Draggfive/Air_Quality_IoT/Eagle PCB/CAMOutputs_Probe/Assembly/Probe_BOM.xlsx

Item # | Designator | Qty | Manufacturer | Mfg Part # | Description | Value | Package | Type
1 | R1 | 1 | Panasonic | ERJ-2RHD1601X | RESISTOR, European symbol | 1.6k ohm | R0402 | R-EU_R0402
2 | R2 | 1 | Panasonic | ERJ-2RHD3300X | RESISTOR, European symbol | 330 ohm | R0402 | R-EU_R0402
3 | R3, R4 | 2 | Panasonic | ERA-2AED103X | RESISTOR, European symbol | 10k ohm | R0402 | R-EU_R0402
4 | R5 | 1 | Panasonic | ERJ-U02D2700X | RESISTOR, European symbol | 270 ohm | R0402 | R-EU_R0402
5 | R6 | 1 | Panasonic | ERA-2AED361X | RESISTOR, European symbol | 360 ohm | R0402 | R-EU_R0402
6 | R7, R8 | 2 | Panasonic | ERJ-2RHD471X | RESISTOR, European symbol | 470 ohm | R0402 | R-EU_R0402
7 | R9, R10, R11, R12 | 4 | Panasonic | ERJ-U02D1001X | RESISTOR, European symbol | 1k ohm | R0402 | R-EU_R0402
8 | C1, C16 | 2 | TDK | C1608X5R0J106K080AE | CAPACITOR, European symbol | 10uF | C0603 | C-EUC0603
9 | C2, C5, C6, C9, C10, C11, C13, C14, C15, C17, C18, C19 | 12 | TDK | CGA2B1X7R1C104K050BC | CAPACITOR, European symbol | 0.1uF | C0402 | C-EUC0402
10 | C3, C4 | 2 | TDK | C2012X7R1H475K125AC | CAPACITOR, European symbol | 4.7uF | C0805 | C-EUC0805
11 | C7, C8 | 2 | TDK | CGA1A2C0G1E120J030BA | CAPACITOR, European symbol | 12.5pF | C0201 | C-EUC0201
12 | C12 | 1 | TDK | C1005X7R1A224K050BB | CAPACITOR, European symbol | 220nF | C0402 | C-EUC0402
13 | D1 | 1 | Wurth Elektronik | 150060GS55040 | WL-SMCD SMT Mono-color Chip LED Diffused | Green | WL-SMCD_0603 | WL-SMCD_0603_150060GS55040
14 | D2 | 1 | Wurth Elektronik | 150060RS55040 | WL-SMCD SMT Mono-color Chip LED Diffused | Red | WL-SMCD_0603 | WL-SMCD_0603_150060RS55040
15 | D3 | 1 | Wurth Elektronik | 150060BS55040 | WL-SMCD SMT Mono-color Chip LED Diffused | Blue | WL-SMCD_0603 | WL-SMCD_0603_150060BS55040
16 | D4 | 1 | Wurth Elektronik | 150060YS55040 | WL-SMCD SMT Mono-color Chip LED Diffused | Yellow | WL-SMCD_0603 | WL-SMCD_0603_150060YS55040
17 | IC1 | 1 | Diodes Incorporated | ZLDO1117G33TA | 1A Low Dropout (LDO) Positive Regulator | REG1117 | SOT223 | REG1117
18 | U1 | 1 | Microchip | PIC32MX170F256D-I/PT | 32-bit PIC Microcontroller | PIC32MX170F256D- | TQFP44_10X10MC | PIC32MX170F256
19 | U2 | 1 | Texas Instruments | TPS2085D | CI commutateur d'alimentation - Alimentation 0.7A 2.7-5.5V Quad Hi-Side MOSFET | TPS2085_D_16 | D16 | TPS2085_D_16
20 | U3 | 1 | Ai-Thinker | Ra-02 | Ra-02 LoRa RF M5Stack Platform Evaluation Expansion Board | RA-02_LORA | MODULE_RA-02_LORA | RA-02_LORA
21 | U4 | 1 | Adafruit | 790 | GPS Module - MTK MT3339 Chipset, -165dBm sensitivity, 22 channels, 10Hz, auto-select external antenna options |  | FGPMMOPA6H | GPS_FGPMMOPA6H
22 | U5 | 1 | Bosch Sensortec | BMP388 | P-Sensor SPI I2C 1, 25 Bar SMD | BMP388 | PQFN50P200X200X80-10N | BMP388
23 | U6 | 1 | STMicroelectronics | IIS2MDCTR | Effet Hall/Capteurs magnétiques enfichables CONSUMER MEMS | IIS2MDCTR | LGA12R50P4X4_200X200X70 | IIS2MDCTR
24 | U7 | 1 | TDK InvenSense | ICM-20649 | Wide-Range 6-Axis MEMS MotionTracking Device for Sports and High Impact Applications Check prices | ICM-20649 | QFN40P300X300X95-24N | ICM-20649
25 | U8 | 1 | Wurth Elektronik | 2525020210001 | WSEN-HIDS - 2525020210001 | WSEN-HIDS_2525020210001 | WSEN-HIDS_2525020210001_SIMPLE | WSEN-HIDS_2525020210001_SIMPLE
26 | X1 | 1 | Hirose Connector | U.FL-R-SMT(10) | U.FL Antenna Connector |  | U.FL | ANTENNA_U.FL
27 | Y1 | 1 | Wurth Elektronik | 830009678 | WE-XTAL Watch Crystals | 32.768kHz | WE-XTAL_CFPX-217 | WE-XTAL_CFPX-217_830009678
