Draggfive/Air_Quality_IoT/SOLIDWORKS Cases/Case_Air/Case_Air.SLDPRT

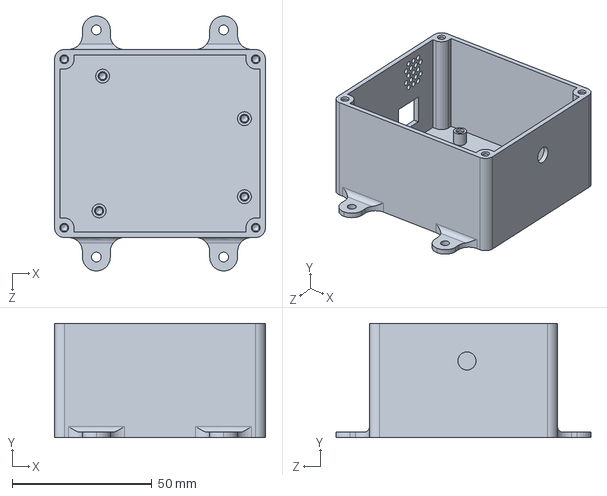
[picture p1: CAD file, 2021-03-29]
SOLIDWORKS Cases/Case_Air/Case_Air.SLDPRT
75.6 x 41.0 x 91.3 mm
