Draggfive/Air_Quality_IoT/SOLIDWORKS Cases/Case_Gateway/Cover_Gateway.SLDPRT

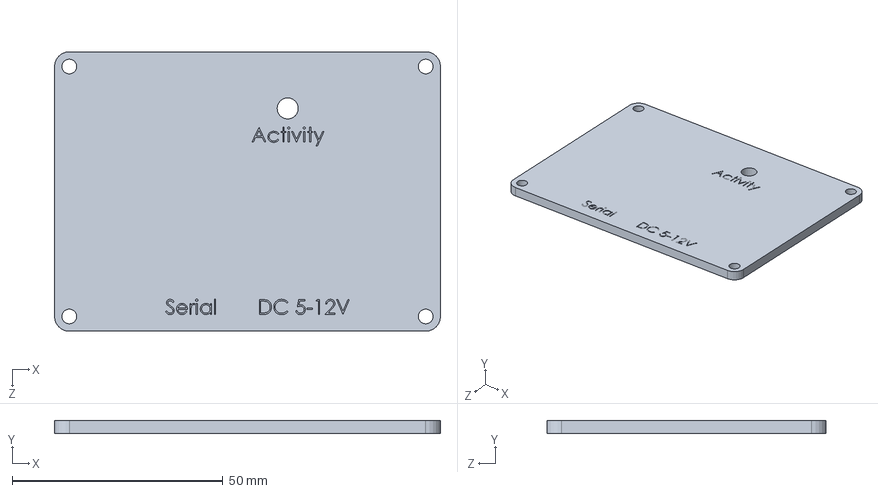
[picture p2: CAD file, 2021-03-29]
SOLIDWORKS Cases/Case_Gateway/Cover_Gateway.SLDPRT
91.5 x 3.00 x 66.2 mm
