Draggfive/Air_Quality_IoT/SOLIDWORKS Cases/Case_Air/Cover_Air.SLDPRT

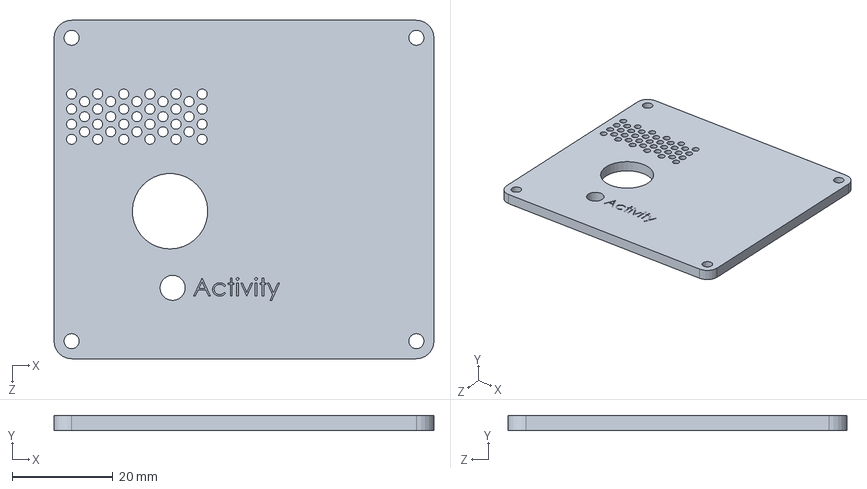
[picture p3: CAD file, 2021-03-29]
SOLIDWORKS Cases/Case_Air/Cover_Air.SLDPRT
75.6 x 3.00 x 67.3 mm
