Draggfive/Air_Quality_IoT/SOLIDWORKS Cases/Case_Gateway/Case_Gateway.SLDPRT

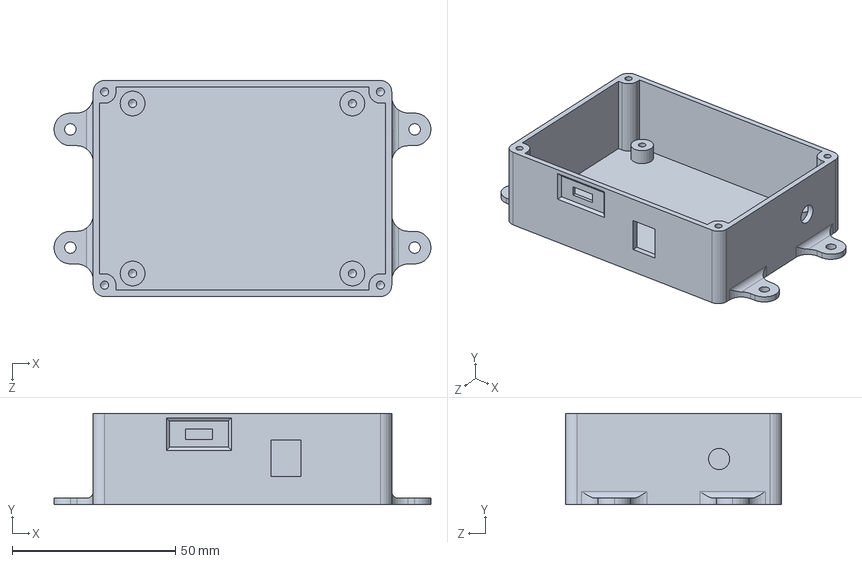
[picture p4: CAD file, 2021-03-29]
SOLIDWORKS Cases/Case_Gateway/Case_Gateway.SLDPRT
115.5 x 28.0 x 66.2 mm
