Draggfive/Air_Quality_IoT/(list of files, cad)

Other CAD files:
SOLIDWORKS Cases/Case_Air/Case_Air.3MF
SOLIDWORKS Cases/Case_Air/Cover_Air.DXF
SOLIDWORKS Cases/Case_Gateway/Case_Gateway.3MF
SOLIDWORKS Cases/Case_Gateway/Cover_Gateway.DXF
