Draggfive/Air_Quality_IoT/Eagle PCB/Probe.brd

## EAGLE design Eagle PCB/Probe.brd (2021-03-29)

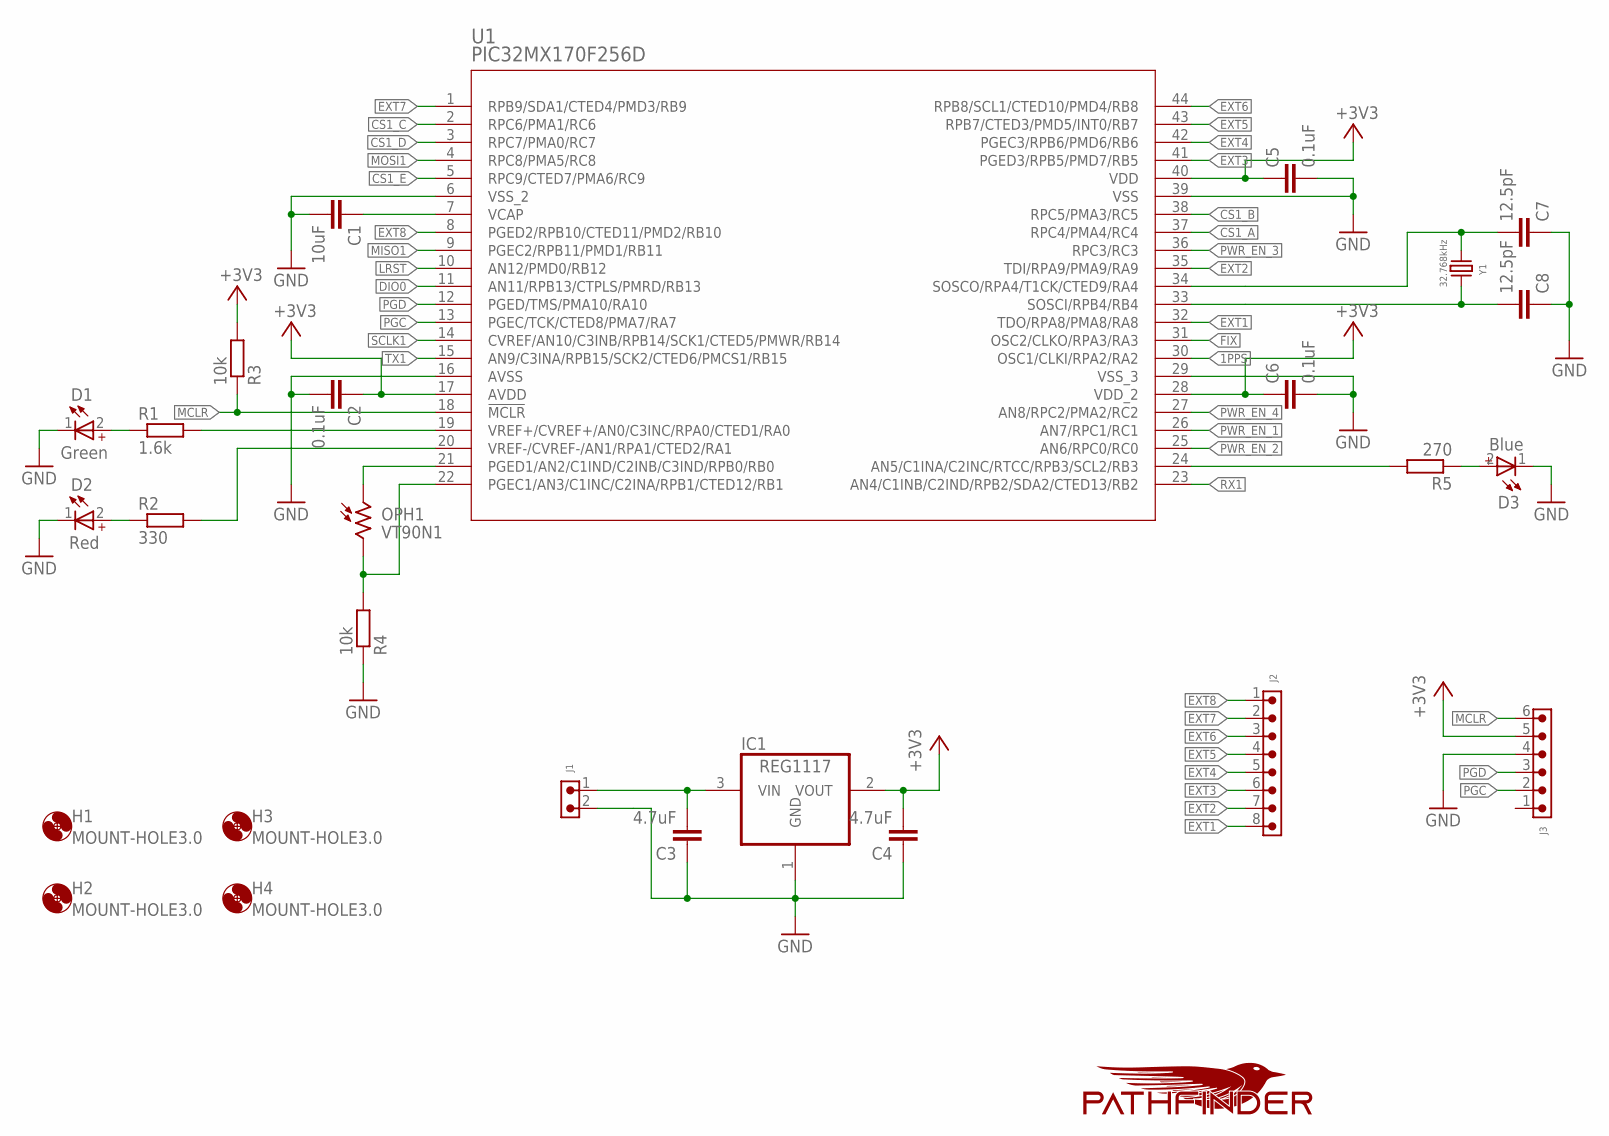
[picture p5: schematic Probe.sch, sheet 1]

Parts:
C1: 10uF; C0603
C2, C5, C6: 0.1uF; C0402
C3, C4: 4.7uF; C0805
C7, C8: 12.5pF; C0201
D1: Green; WL-SMCD_0603
D2: Red; WL-SMCD_0603
D3: Blue; WL-SMCD_0603
H1, H2, H3, H4: MOUNT-HOLE3.0; 3,0
IC1: REG1117; SOT223
J1: 6130XX11021_61300211021; 61300211021
J2: 6130XX11021_61300811021; 61300811021
J3: 6130XX11021_61300611021; 61300611021
OPH1: VT90N1; VT900
R1: 1.6k; R0402
R2: 330; R0402
R3, R4: 10k; R0402
R5: 270; R0402
U1: PIC32MX170F256D; TQFP44_10X10MC
U$1: PATHFINDER_LOGO24MM_6MIL_S; PATHFINDER_LOGO_24MM_6MIL_SERIGRAPHY
Y1: 32.768kHz; WE-XTAL_CFPX-217

Connections:
1PPS: U1.30 (OSC1/CLKI/RPA2/RA2); also elsewhere on the board
+3V3: C2.1, C4.2, C5.1, C6.1, IC1.2 (VOUT), J3.5, R3.2, U1.17 (AVDD), U1.28 (VDD_2), U1.40 (VDD); also elsewhere on the board
CS1_A: U1.37 (RPC4/PMA4/RC4); also elsewhere on the board
CS1_B: U1.38 (RPC5/PMA3/RC5); also elsewhere on the board
CS1_C: U1.2 (RPC6/PMA1/RC6); also elsewhere on the board
CS1_D: U1.3 (RPC7/PMA0/RC7); also elsewhere on the board
CS1_E: U1.5 (RPC9/CTED7/PMA6/RC9); also elsewhere on the board
DIO0: U1.11 (AN11/RPB13/CTPLS/PMRD/RB13); also elsewhere on the board
EXT1: J2.8, U1.32 (TDO/RPA8/PMA8/RA8)
EXT2: J2.7, U1.35 (TDI/RPA9/PMA9/RA9)
EXT3: J2.6, U1.41 (PGED3/RPB5/PMD7/RB5)
EXT4: J2.5, U1.42 (PGEC3/RPB6/PMD6/RB6)
EXT5: J2.4, U1.43 (RPB7/CTED3/PMD5/INT0/RB7)
EXT6: J2.3, U1.44 (RPB8/SCL1/CTED10/PMD4/RB8)
EXT7: J2.2, U1.1 (RPB9/SDA1/CTED4/PMD3/RB9)
EXT8: J2.1, U1.8 (PGED2/RPB10/CTED11/PMD2/RB10)
FIX: U1.31 (OSC2/CLKO/RPA3/RA3); also elsewhere on the board
GND: C1.2, C2.2, C3.1, C4.1, C5.2, C6.2, C7.1, C8.1, D1.1 (_), D2.1 (_), D3.1 (_), IC1.1 (GND), J1.2, J3.4, R4.1, U1.6 (VSS_2), U1.16 (AVSS), U1.29 (VSS_3), U1.39 (VSS); also elsewhere on the board
LRST: U1.10 (AN12/PMD0/RB12); also elsewhere on the board
MCLR: J3.6, R3.1, U1.18 (!MCLR)
MISO1: U1.9 (PGEC2/RPB11/PMD1/RB11); also elsewhere on the board
MOSI1: U1.4 (RPC8/PMA5/RC8); also elsewhere on the board
unnamed: C1.1, U1.7 (VCAP)
unnamed: C7.2, U1.34 (SOSCO/RPA4/T1CK/CTED9/RA4), Y1.2
unnamed: C8.2, U1.33 (SOSCI/RPB4/RB4), Y1.1
unnamed: D1.2 (+), R1.1
unnamed: D2.2 (+), R2.1
unnamed: OPH1.1, U1.21 (PGED1/AN2/C1IND/C2INB/C3IND/RPB0/RB0)
unnamed: R1.2, U1.19 (VREF+/CVREF+/AN0/C3INC/RPA0/CTED1/RA0)
unnamed: R2.2, U1.20 (VREF-/CVREF-/AN1/RPA1/CTED2/RA1)
unnamed: OPH1.2, R4.2, U1.22 (PGEC1/AN3/C1INC/C2INA/RPB1/CTED12/RB1)
unnamed: C3.2, IC1.3 (VIN), J1.1
unnamed: R5.2, U1.24 (AN5/C1INA/C2INC/RTCC/RPB3/SCL2/RB3)
unnamed: D3.2 (+), R5.1
PGC: J3.2, U1.13 (PGEC/TCK/CTED8/PMA7/RA7)
PGD: J3.3, U1.12 (PGED/TMS/PMA10/RA10)
PWR_EN_1: U1.26 (AN7/RPC1/RC1); also elsewhere on the board
PWR_EN_2: U1.25 (AN6/RPC0/RC0); also elsewhere on the board
PWR_EN_3: U1.36 (RPC3/RC3); also elsewhere on the board
PWR_EN_4: U1.27 (AN8/RPC2/PMA2/RC2); also elsewhere on the board
RX1: U1.23 (AN4/C1INB/C2IND/RPB2/SDA2/CTED13/RB2); also elsewhere on the board
SCLK1: U1.14 (CVREF/AN10/C3INB/RPB14/SCK1/CTED5/PMWR/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); also elsewhere on the board
TX1: U1.15 (AN9/C3INA/RPB15/SCK2/CTED6/PMCS1/RB15); also elsewhere on the board

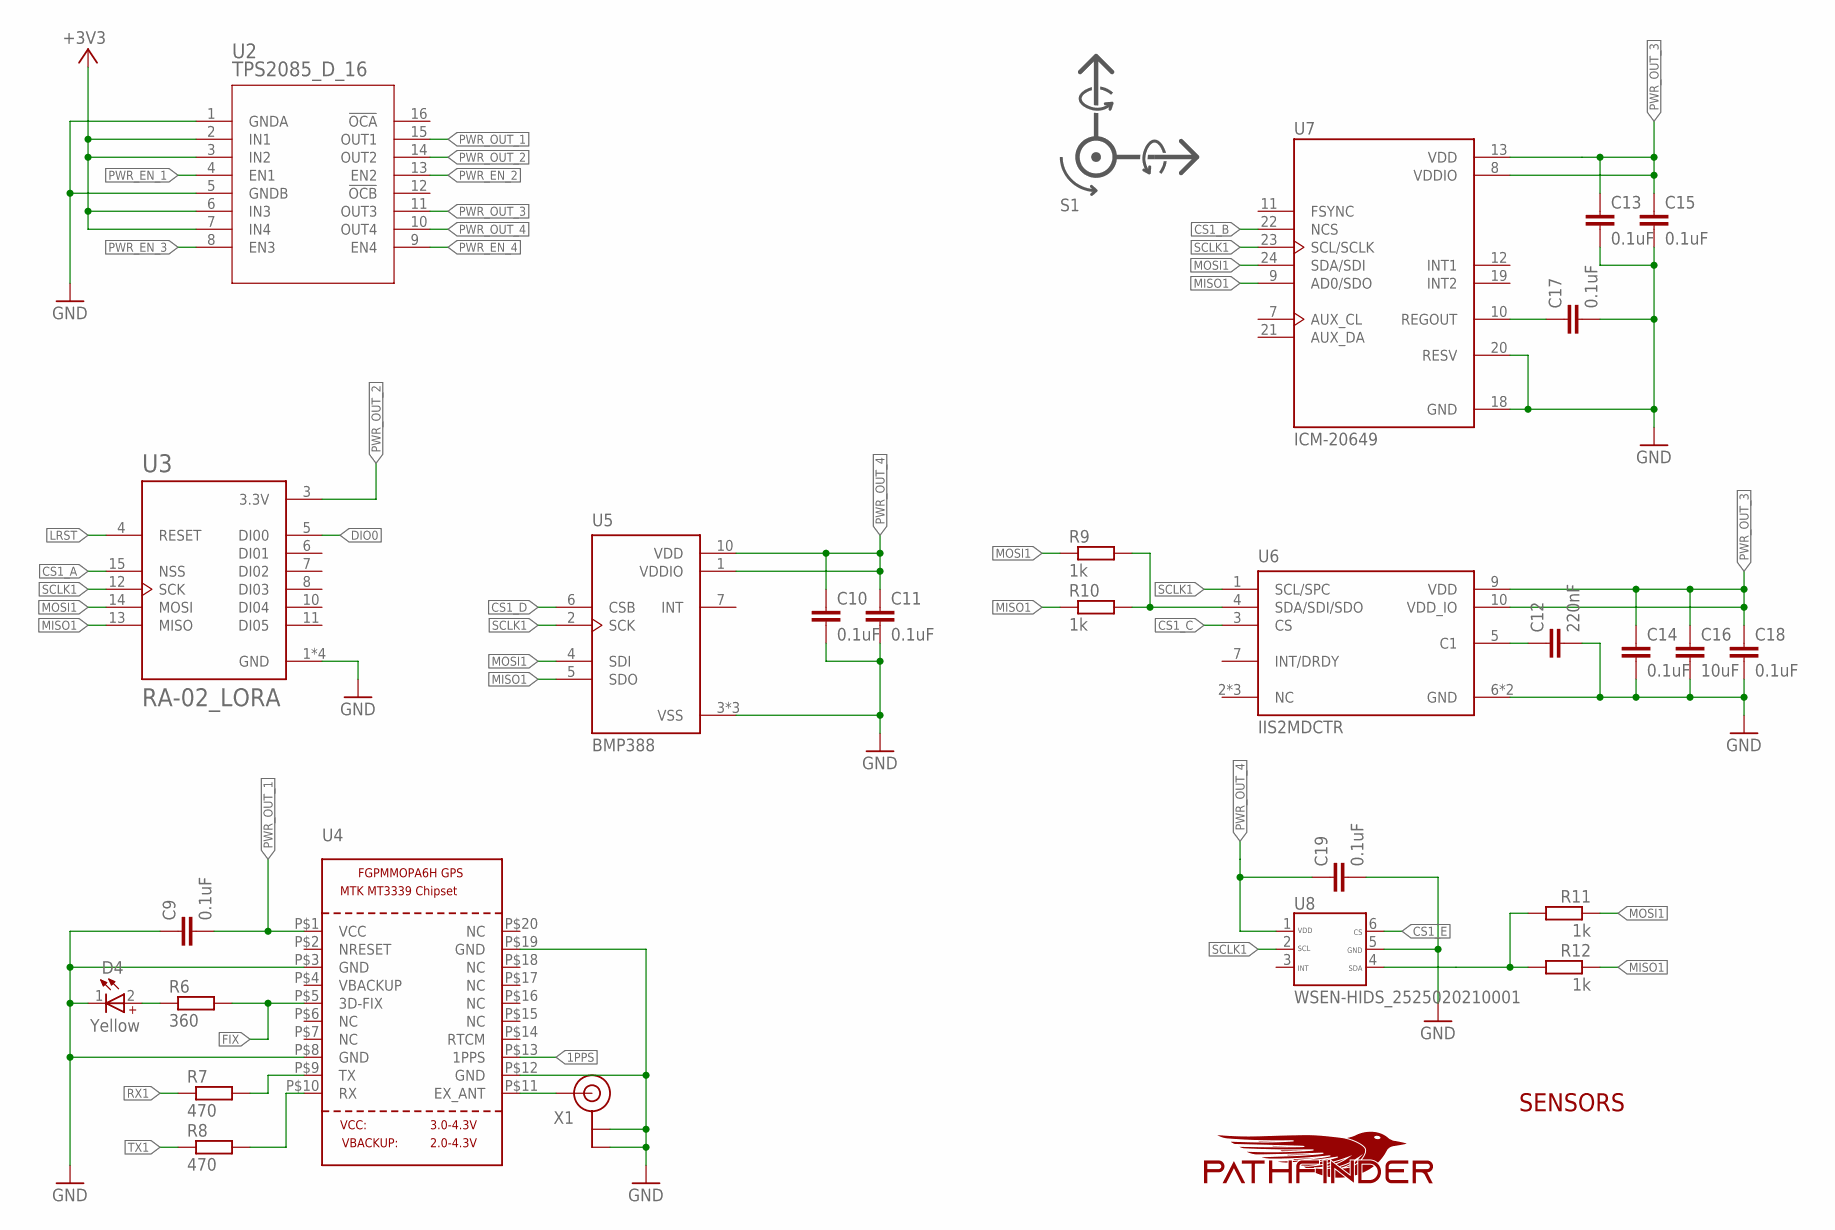
[picture p6: schematic Probe.sch, sheet 2]

Parts:
C9, C10, C11, C13, C14, C15, C17, C18, C19: 0.1uF; C0402
C12: 220nF; C0402
C16: 10uF; C0603
D4: Yellow; WL-SMCD_0603
R6: 360; R0402
R7, R8: 470; R0402
R9, R10, R11, R12: 1k; R0402
S1: COORDINATE_SYSTEM; DIRECT_AXES
U2: TPS2085_D_16; D16
U3: RA-02_LORA; MODULE_RA-02_LORA
U4: GPS_FGPMMOPA6H; FGPMMOPA6H
U5: BMP388; PQFN50P200X200X80-10N
U6: IIS2MDCTR; LGA12R50P4X4_200X200X70
U7: ICM-20649; QFN40P300X300X95-24N
U8: WSEN-HIDS_2525020210001; WSEN-HIDS_2525020210001_SIMPLE
U$2: PATHFINDER_LOGO24MM_6MIL_S; PATHFINDER_LOGO_24MM_6MIL_SERIGRAPHY
X1: ANTENNA_U.FL; U.FL

Connections:
1PPS: U4.P$13 (1PPS); also elsewhere on the board
+3V3: U2.2 (IN1), U2.3 (IN2), U2.6 (IN3), U2.7 (IN4); also elsewhere on the board
CS1_A: U3.15 (NSS); also elsewhere on the board
CS1_B: U7.22 (NCS); also elsewhere on the board
CS1_C: U6.3 (CS); also elsewhere on the board
CS1_D: U5.6 (CSB); also elsewhere on the board
CS1_E: U8.6 (CS); also elsewhere on the board
DIO0: U3.5 (DI00); also elsewhere on the board
FIX: R6.2, U4.P$5 (3D-FIX); also elsewhere on the board
GND: C9.1, C10.2, C11.2, C12.2, C13.2, C14.2, C15.2, C16.2, C17.2, C18.2, C19.2, D4.1 (_), U2.1 (GNDA), U2.5 (GNDB), U3.1 (GND), U3.2 (GND), U3.9 (GND), U3.16 (GND), U4.P$3 (GND), U4.P$8 (GND), U4.P$12 (GND), U4.P$19 (GND), U5.3 (VSS), U5.8 (VSS), U5.9 (VSS), U6.6 (GND), U6.8 (GND), U7.18 (GND), U7.20 (RESV), U8.5 (GND), X1.1 (GND), X1.2 (GND); also elsewhere on the board
LRST: U3.4 (RESET); also elsewhere on the board
MISO1: R10.1, R12.1, U3.13 (MISO), U5.5 (SDO), U7.9 (AD0/SDO); also elsewhere on the board
MOSI1: R9.1, R11.1, U3.14 (MOSI), U5.4 (SDI), U7.24 (SDA/SDI); also elsewhere on the board
unnamed: C17.1, U7.10 (REGOUT)
unnamed: D4.2 (+), R6.1
unnamed: U4.P$11 (EX_ANT), X1.3 (SIGNAL)
unnamed: R7.2, U4.P$9 (TX)
unnamed: R8.2, U4.P$10 (RX)
unnamed: R9.2, R10.2, U6.4 (SDA/SDI/SDO)
unnamed: C12.1, U6.5 (C1)
unnamed: R11.2, R12.2, U8.4 (SDA)
PWR_EN_1: U2.4 (EN1); also elsewhere on the board
PWR_EN_2: U2.13 (EN2); also elsewhere on the board
PWR_EN_3: U2.8 (EN3); also elsewhere on the board
PWR_EN_4: U2.9 (EN4); also elsewhere on the board
PWR_OUT_1: C9.2, U2.15 (OUT1), U4.P$1 (VCC)
PWR_OUT_2: U2.14 (OUT2), U3.3 (3.3V)
PWR_OUT_3: C13.1, C14.1, C15.1, C16.1, C18.1, U2.11 (OUT3), U6.9 (VDD), U6.10 (VDD_IO), U7.8 (VDDIO), U7.13 (VDD)
PWR_OUT_4: C10.1, C11.1, C19.1, U2.10 (OUT4), U5.1 (VDDIO), U5.10 (VDD), U8.1 (VDD)
RX1: R7.1; also elsewhere on the board
SCLK1: U3.12 (SCK), U5.2 (SCK), U6.1 (SCL/SPC), U7.23 (SCL/SCLK), U8.2 (SCL); also elsewhere on the board
TX1: R8.1; also elsewhere on the board

Notes on the sheet:
SENSORS

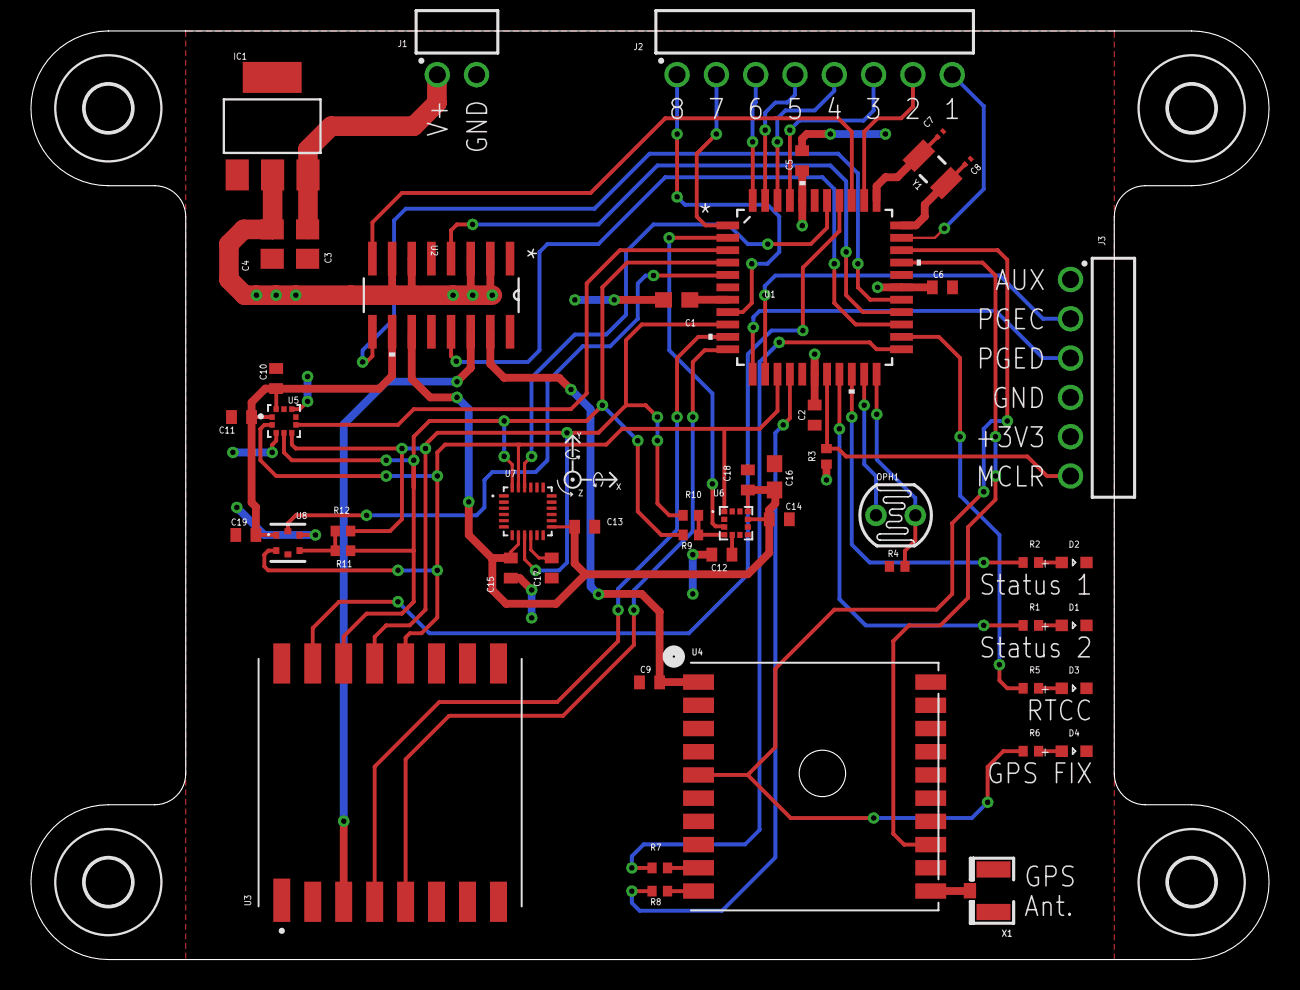
[picture p7: board Probe.brd from above]

Board: 2 copper layers, 80.0 x 60.0 mm, 57 parts (1 on the bottom side), 55 nets.
