Draggfive/Air_Quality_IoT/Eagle PCB/Gateway.brd

## EAGLE design Eagle PCB/Gateway.brd (2021-03-29)

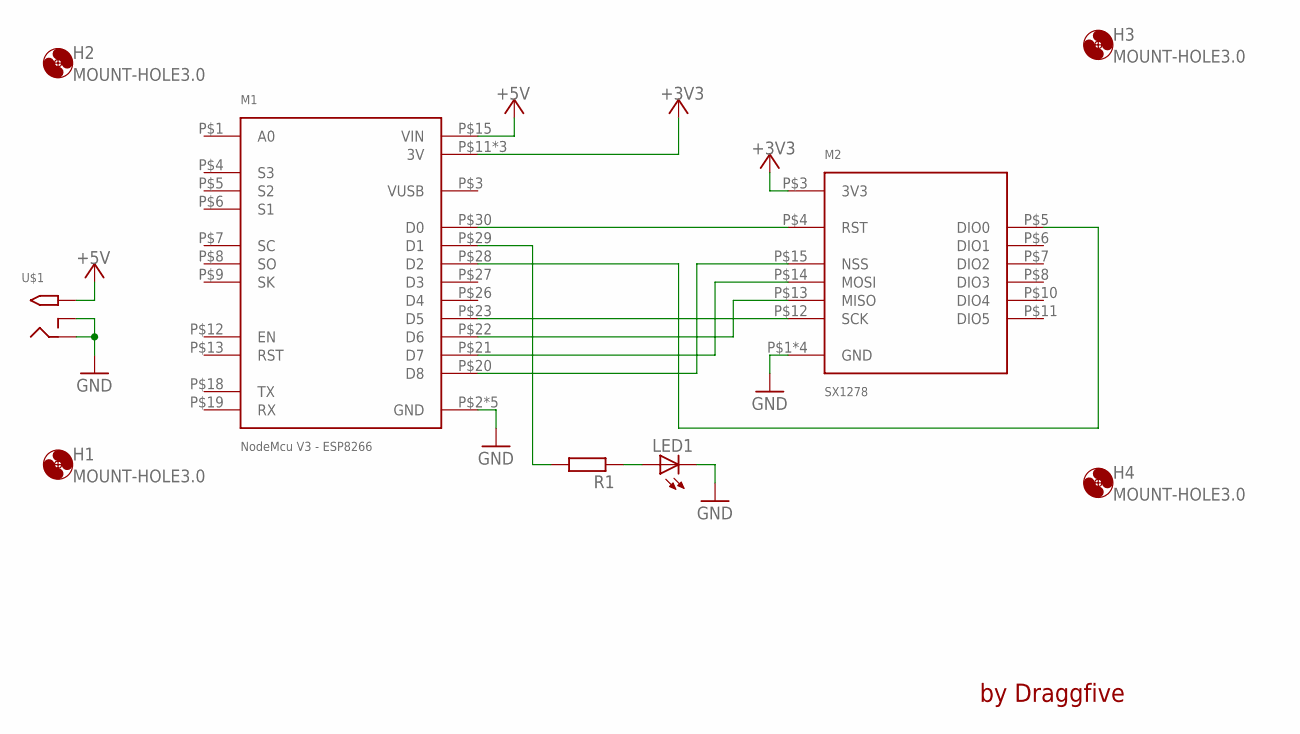
[picture p8: schematic Gateway.sch]

Parts:
H1, H2, H3, H4: MOUNT-HOLE3.0; 3,0
LED1: LED5MM
M1: NodeMcu V3 - ESP8266; NODEMCU_V3
M2: SX1278
R1: R-EU_0207/10; 0207/10
U$1: 2.1MMJACKTHM; PJ-102A

Connections:
+3V3: M1.P$11 (3V), M1.P$16 (3V), M1.P$25 (3V), M2.P$3 (3V3)
+5V: M1.P$15 (VIN), U$1.TIP
GND: LED1.K (C), M1.P$2 (GND), M1.P$10 (GND), M1.P$14 (GND), M1.P$17 (GND), M1.P$24 (GND), M2.P$1 (GND), M2.P$2 (GND), M2.P$9 (GND), M2.P$16 (GND), U$1.RING, U$1.RING_SW
unnamed: M1.P$29 (D1), R1.2
unnamed: M1.P$30 (D0), M2.P$4 (RST)
unnamed: M1.P$28 (D2), M2.P$5 (DIO0)
unnamed: M1.P$23 (D5), M2.P$12 (SCK)
unnamed: M1.P$22 (D6), M2.P$13 (MISO)
unnamed: M1.P$21 (D7), M2.P$14 (MOSI)
unnamed: M1.P$20 (D8), M2.P$15 (NSS)
unnamed: LED1.A, R1.1

Notes on the sheet:
by Draggfive

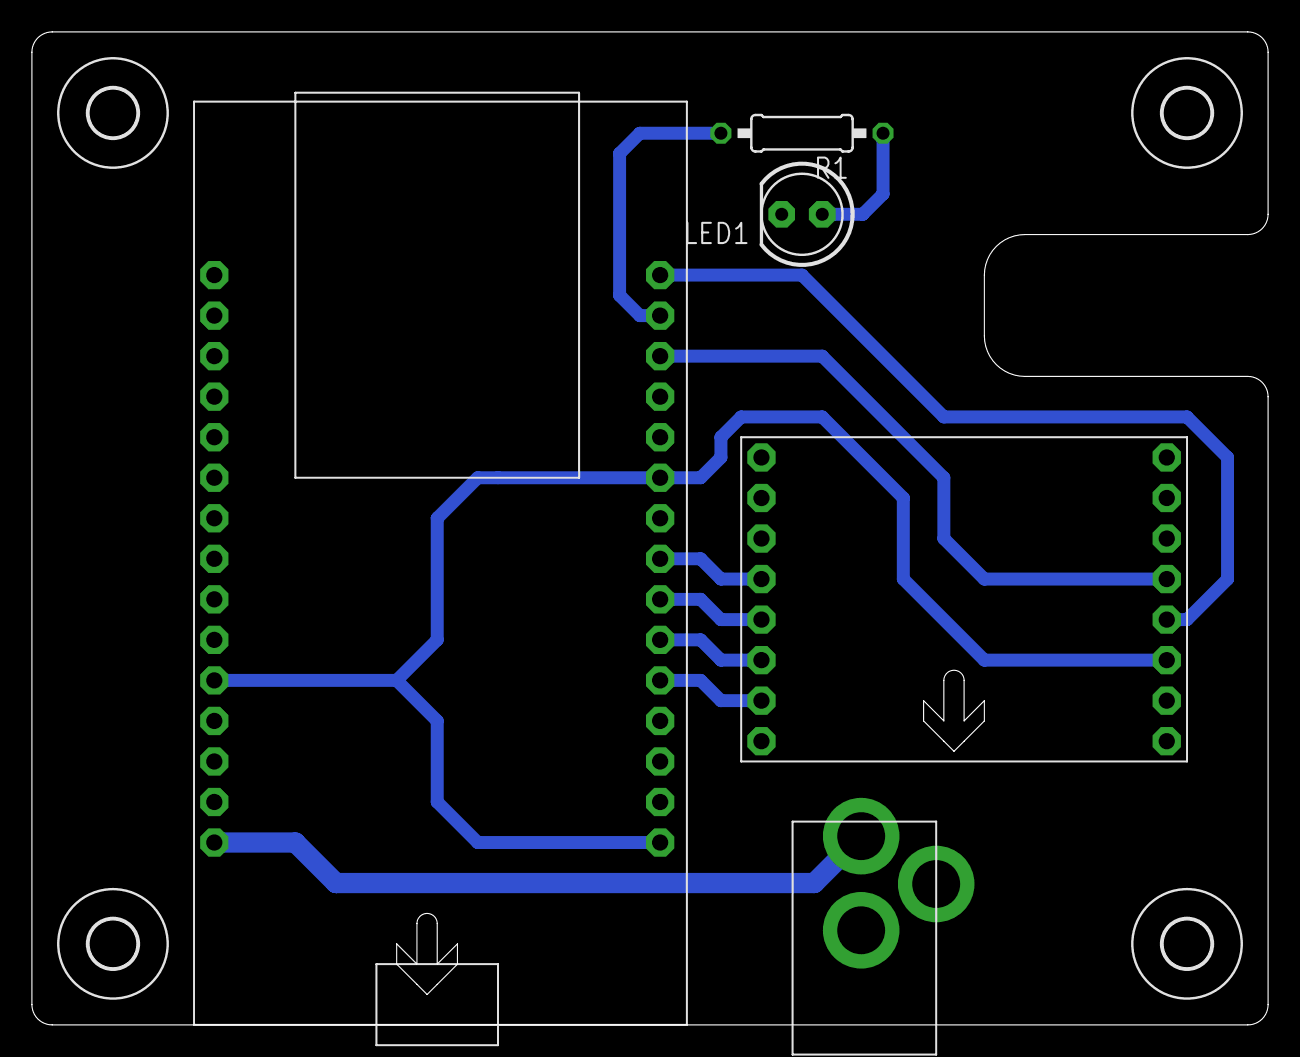
[picture p9: board Gateway.brd from above]

Board: 2 copper layers, 77.5 x 62.2 mm, 9 parts (0 on the bottom side), 11 nets.
