Draggfive/Air_Quality_IoT/Eagle PCB/Air Quality.brd

## EAGLE design Eagle PCB/Air Quality.brd (2021-03-29)

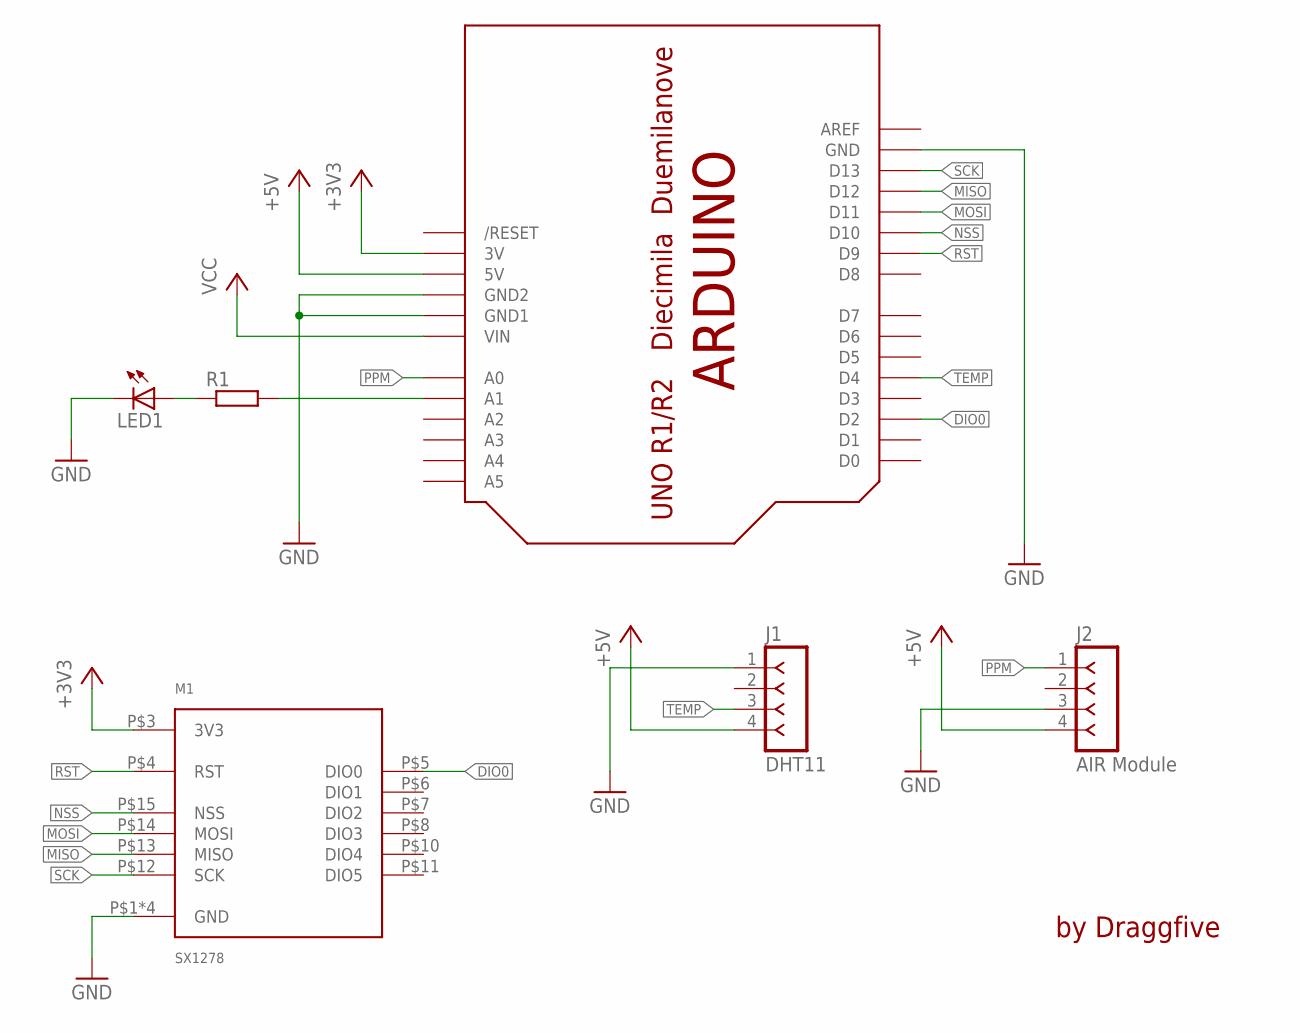
[picture p10: schematic Air Quality.sch]

Parts:
J1: DHT11; SIP-100-04-32Y
J2: AIR Module; SIP-100-04-40Y
LED1: LED5MM
M1: SX1278
R1: R-EU_0207/10; 0207/10
U$1: ARDUINOUNO; ARDUINO

Connections:
+3V3: M1.P$3 (3V3), U$1.3V
+5V: J1.4, J2.4, U$1.5V
DIO0: M1.P$5 (DIO0), U$1.D2
GND: J1.1, J2.3, LED1.K (C), M1.P$1 (GND), M1.P$2 (GND), M1.P$9 (GND), M1.P$16 (GND), U$1.GND, U$1.GND1, U$1.GND2
MISO: M1.P$13 (MISO), U$1.D12
MOSI: M1.P$14 (MOSI), U$1.D11
unnamed: LED1.A, R1.1
unnamed: R1.2, U$1.A1
NSS: M1.P$15 (NSS), U$1.D10
PPM: J2.1, U$1.A0
RST: M1.P$4 (RST), U$1.D9
SCK: M1.P$12 (SCK), U$1.D13
TEMP: J1.3, U$1.D4
VCC: U$1.VIN

Notes on the sheet:
by Draggfive

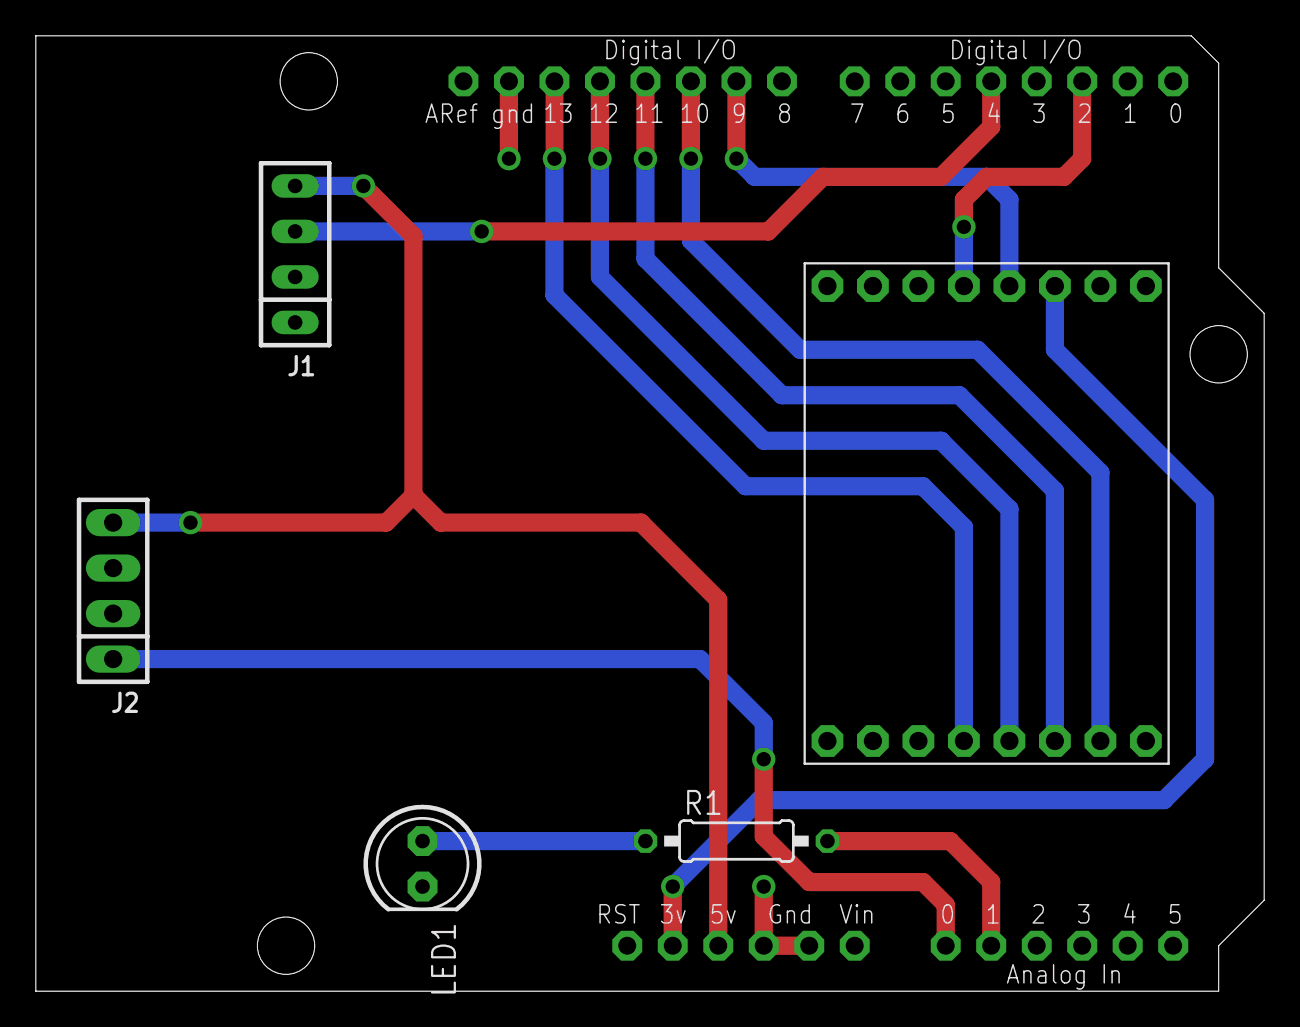
[picture p11: board Air Quality.brd from above]

Board: 2 copper layers, 68.6 x 53.3 mm, 6 parts (0 on the bottom side), 13 nets.
