Draggfive/Air_Quality_IoT/(commit log)

2021-03-29 Assignment Update
    [Air Quality.brd, Air Quality.sch, Case_Air.3MF, Case_Air.SLDPRT, Case_Gateway.3MF, Case_Gateway.SLDPRT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]
2021-03-29 Work in Progress
    [PnP_Probe_front.csv, Probe.brd, Probe.sch, Probe_BOM.xlsx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]
2021-04-22 Added support for industrial manufacturing
    [Air Quality.gbl, Air Quality.gtl, Gateway.gbl, Gateway.gtl, copper_bottom.gbr, copper_top.gbr, drill_1_16.xln, gerber_job.gbrjob]
