Draggfive/Air_Quality_IoT/(notices)

Notices in the files:
parts and their libraries:
Wurth_LEDs_WL-SMCD: Copyright: Würth Elektronik
con-headers-jp: Copyright (C) 2008, Bob Starr
